PittRocketryTeam/Vehicle-Subsystem/hardware/PCBs/PowerDeliveryBoard.png

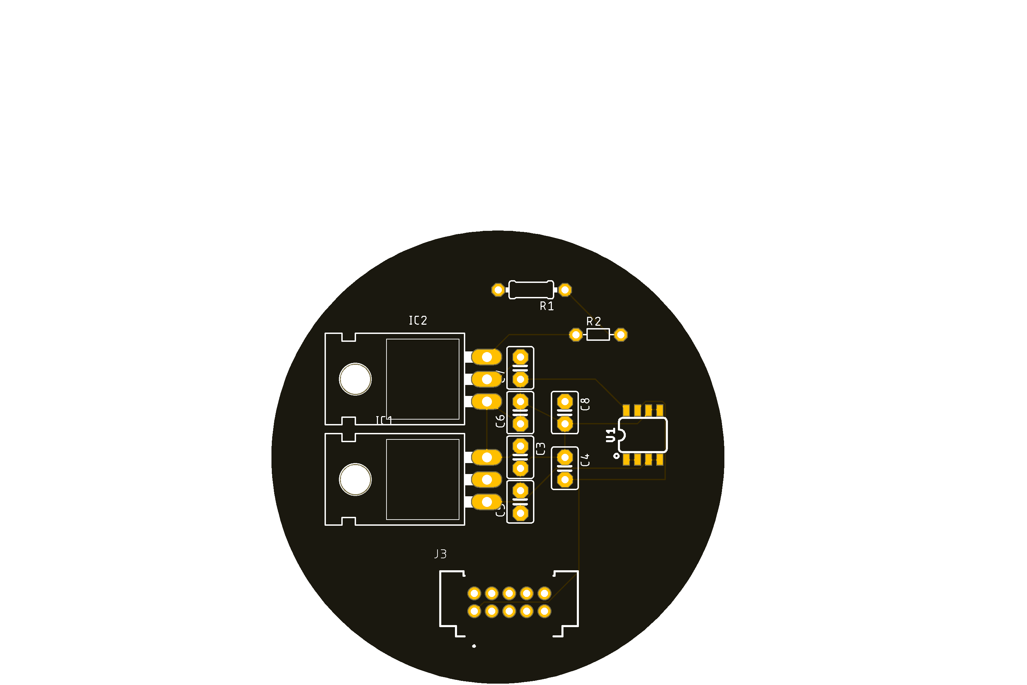
hardware/PCBs/PowerDeliveryBoard.png
