PittRocketryTeam/Vehicle-Subsystem/hardware/schematics/GroundStation/Ground_Station_Board.png

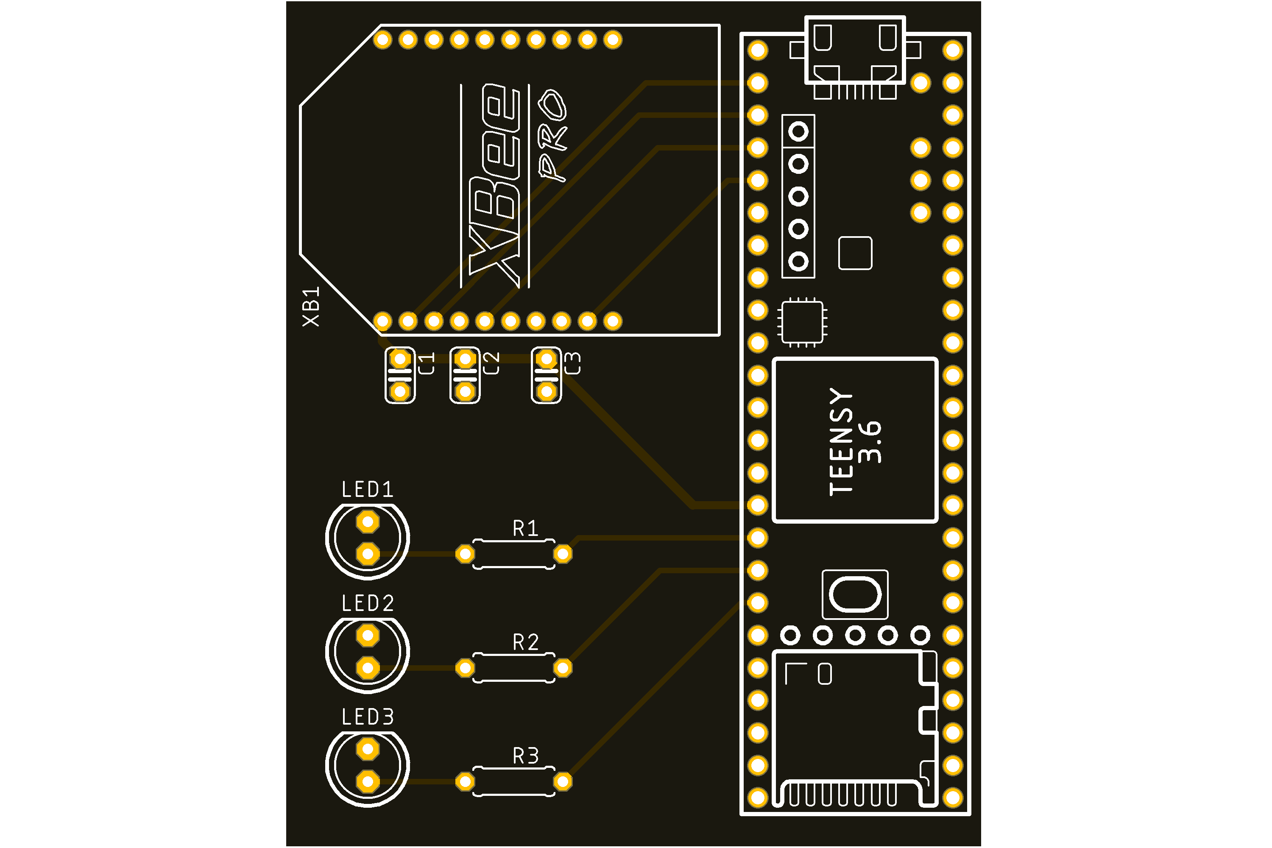
hardware/schematics/GroundStation/Ground_Station_Board.png
