PittRocketryTeam/Vehicle-Subsystem/hardware/schematics/MainBoard/MainBoard.png

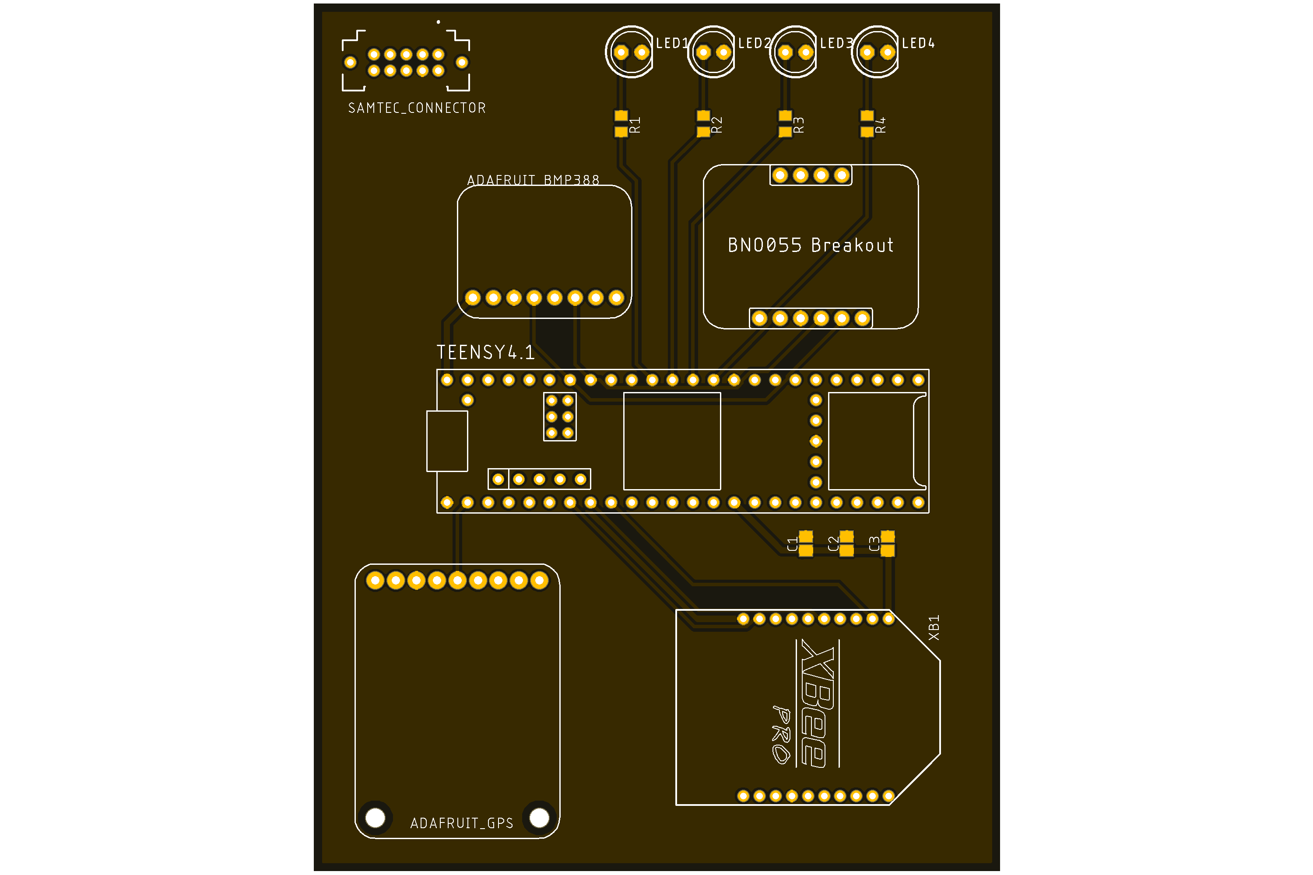
hardware/schematics/MainBoard/MainBoard.png
