PittRocketryTeam/Vehicle-Subsystem/hardware/schematics/GroundStation/Ground_Station_PCB.pdf

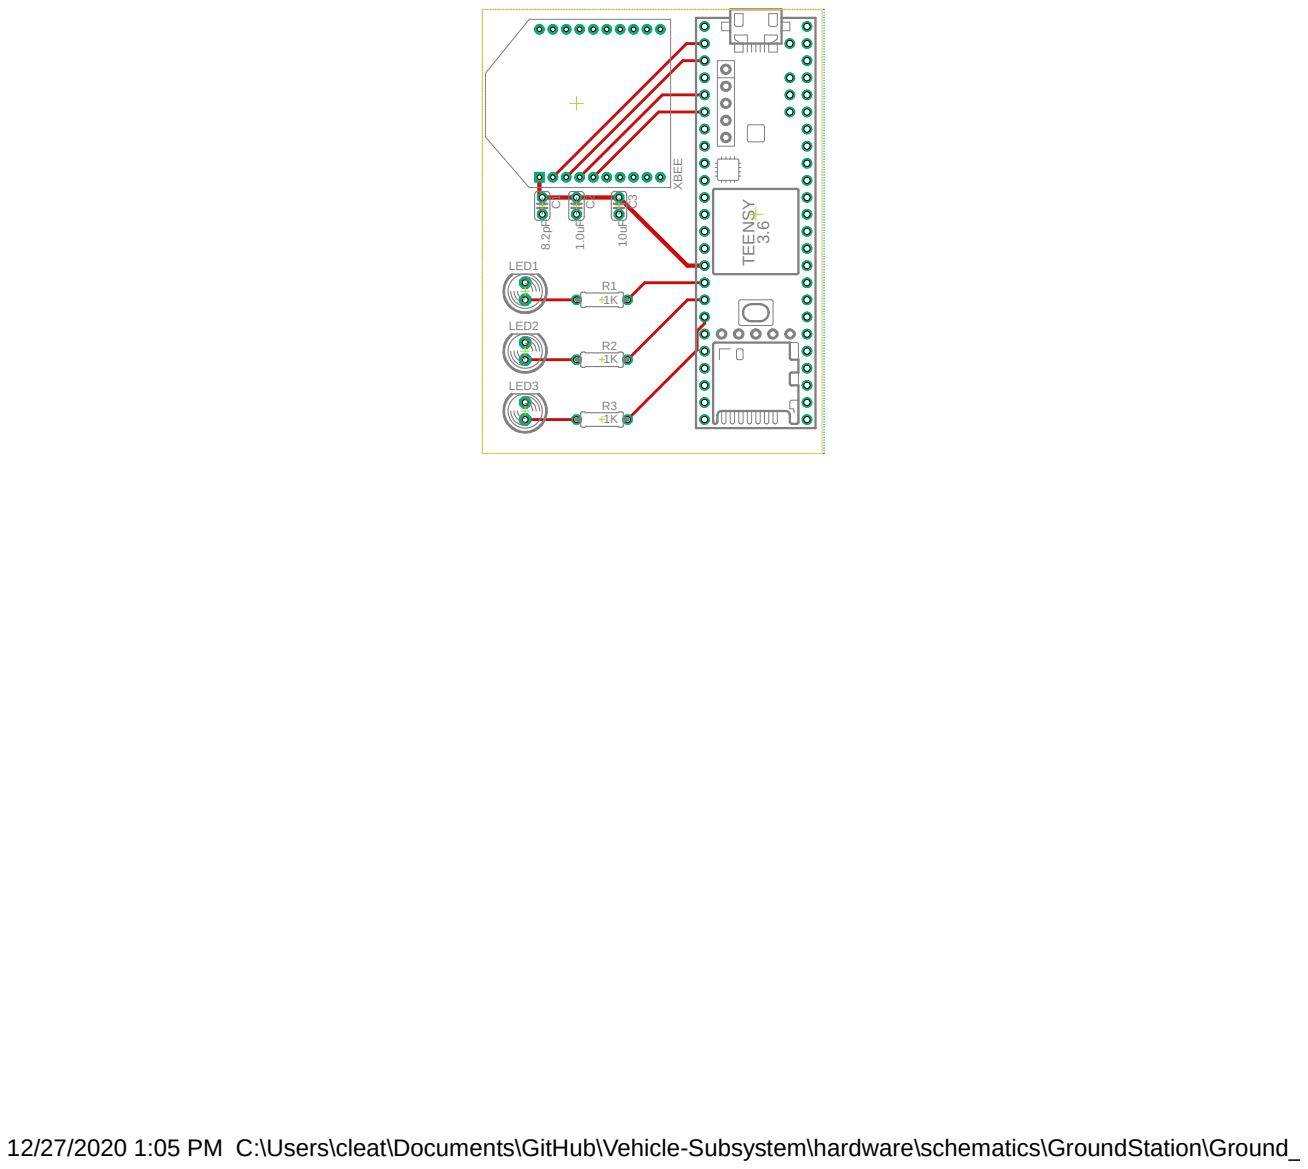
[picture p4: page 1]
12/27/2020 1:05 PM C:\Users\cleat\Documents\GitHub\Vehicle-Subsystem\hardware\schematics\GroundStation\Ground_Station_Board.brd TEENSY 3.6 C¹; LED1; LED2; LED3; XBEE 8.2pF
