PittRocketryTeam/Vehicle-Subsystem/hardware/schematics/MainBoard/MainboardPCB.pdf

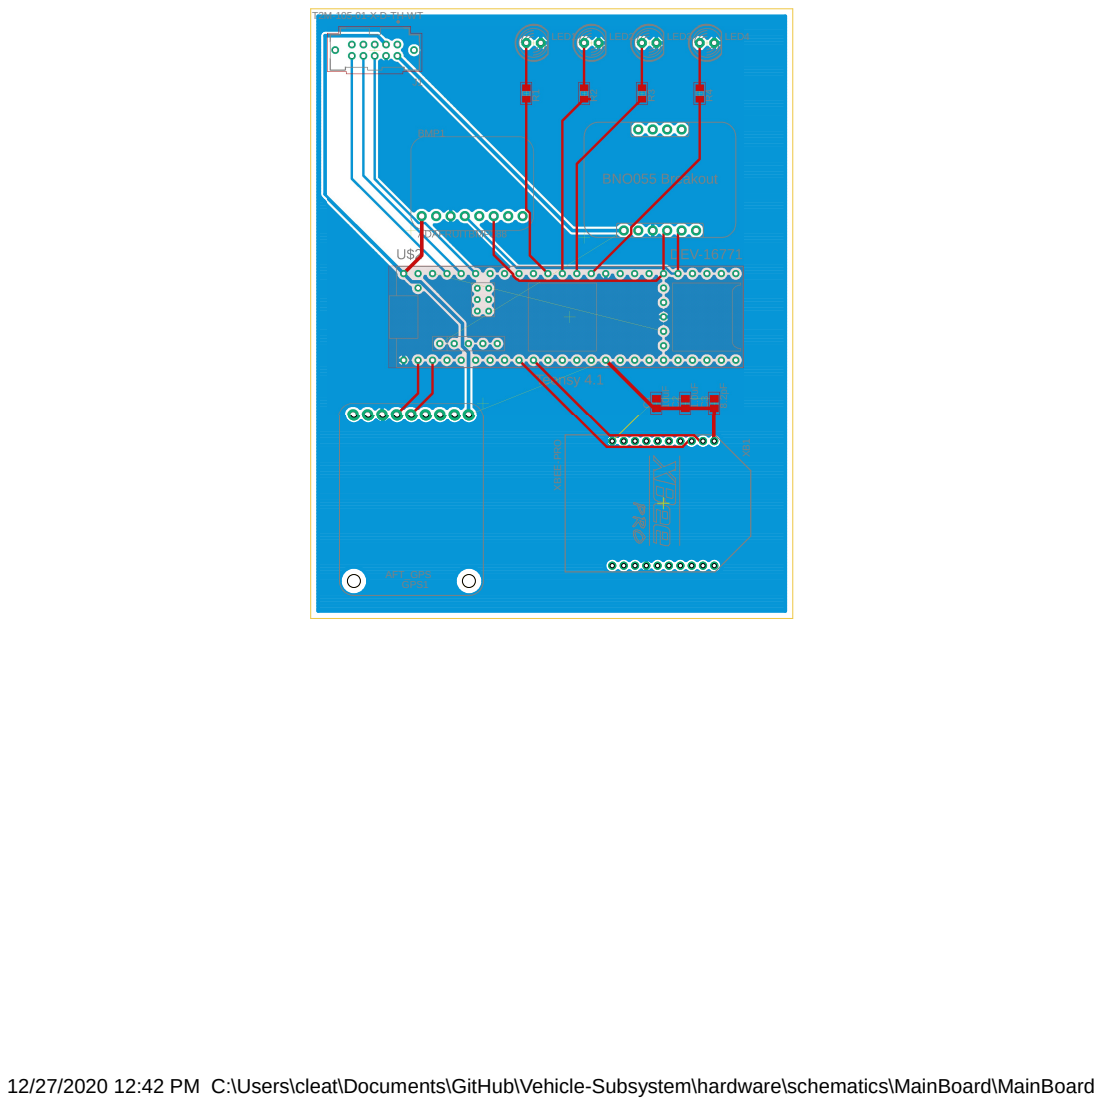
[picture p5: page 1]
GPS1; AFT_GPS; XBEE⁻PRO

12/27/2020 12:42 PM C:\Users\cleat\Documents\GitHub\Vehicle-Subsystem\hardware\schematics\MainBoard\MainBoard.brd
