PittRocketryTeam/Vehicle-Subsystem/hardware/schematics/MainBoard/MainboardSchematic.pdf

## Indicator LED's

## Power Board Connector

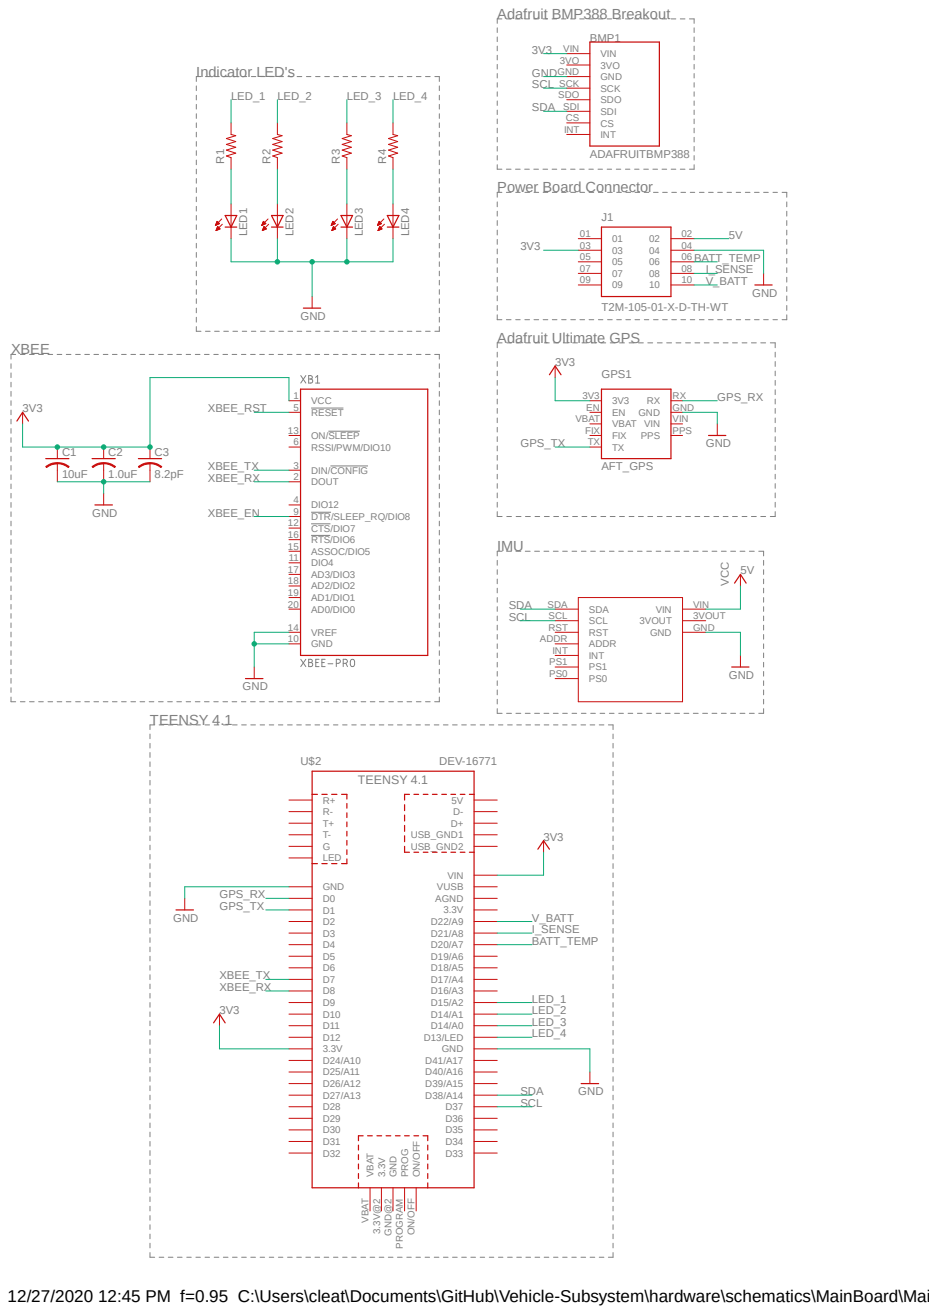
[picture p6: page 1]

12/27/2020 12:45 PM f=0.95 C:\Users\cleat\Documents\GitHub\Vehicle-Subsystem\hardware\schematics\MainBoard\MainBoard.sch (Sheet: 1/1)
