PittRocketryTeam/Vehicle-Subsystem/hardware/schematics/GroundStation/Ground_Station_Schematic.pdf

## Indicator LEDS

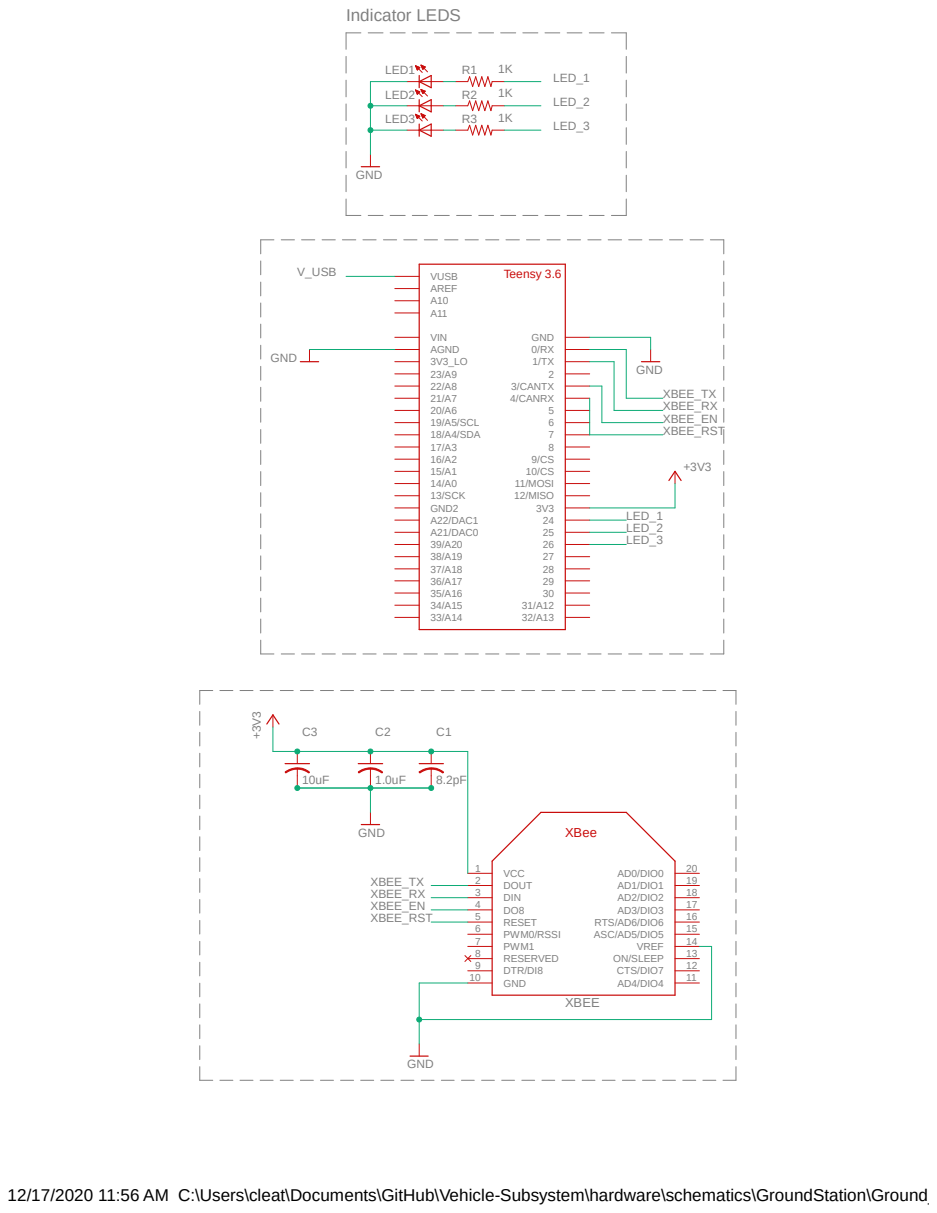
[picture p7: page 1]

12/17/2020 11:56 AM C:\Users\cleat\Documents\GitHub\Vehicle-Subsystem\hardware\schematics\GroundStation\Ground_Station_Board.sch (Sheet: 1/1)
