PittRocketryTeam/Vehicle-Subsystem/hardware/Finished Designs/Power Delivery Board/PowerDeliveryBoard.brd

## EAGLE design hardware/Finished Designs/Power Delivery Board/PowerDeliveryBoard.brd (2021-01-24)

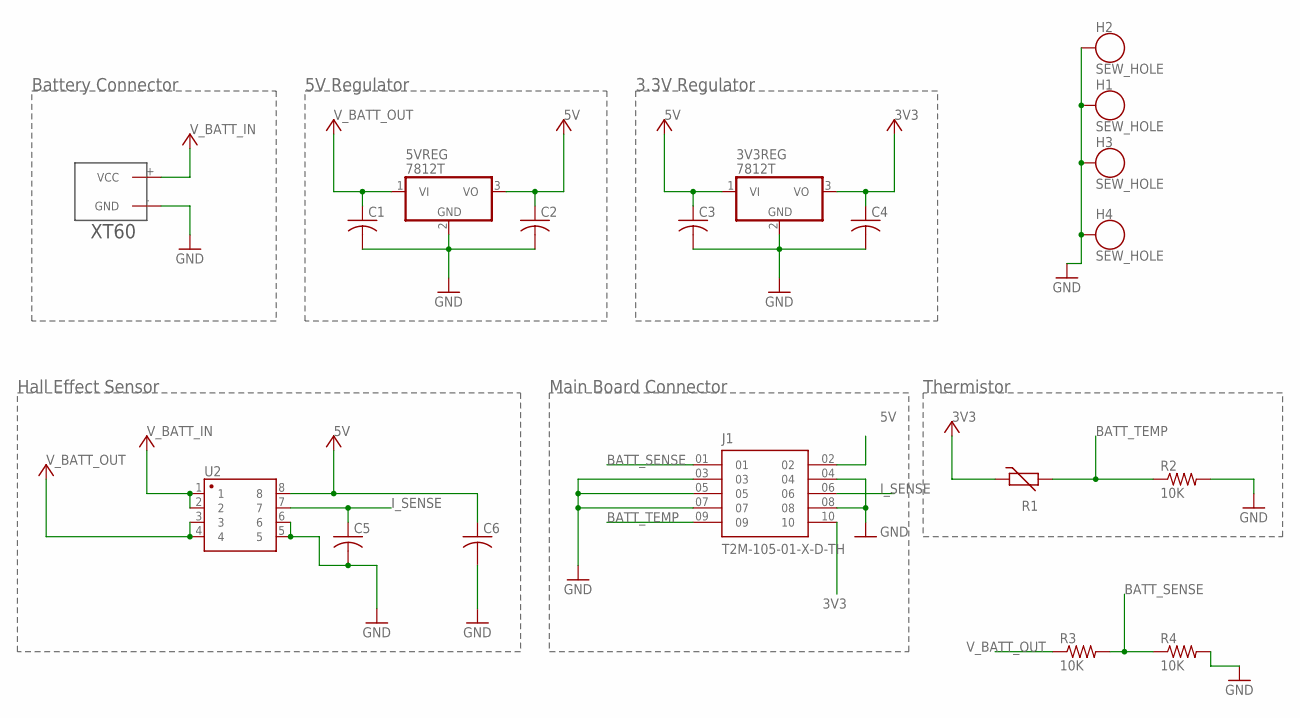
[picture p8: schematic PowerDeliveryBoard.sch]

Parts:
3V3REG, 5VREG: 7812T; TO220H
C1, C2, C3, C4, C5, C6: C-USC0805; C0805
H1, H2, H3, H4: SEW_HOLE; SIMPLE_HOLE
J1: T2M-105-01-X-D-TH; SAMTEC_T2M-105-01-X-D-TH
R1: THERMISTOR-5; R-5
R2, R3, R4: 10K; R0805
U2: ASC723; SO08
U$3: XT60_XT60

Connections:
3V3: 3V3REG.3 (VO), C4.1, J1.10, R1.1
5V: 3V3REG.1 (VI), 5VREG.3 (VO), C2.1, C3.1, C6.1, J1.02, U2.8
BATT_SENSE: J1.01, R3.2, R4.1
BATT_TEMP: J1.09, R1.2, R2.1
GND: 3V3REG.2 (GND), 5VREG.2 (GND), C1.2, C2.2, C3.2, C4.2, C5.2, C6.2, H1.P$1, H2.P$1, H3.P$1, H4.P$1, J1.03, J1.04, J1.05, J1.07, J1.08, R2.2, R4.2, U2.5, U2.6, U$3.- (GND)
I_SENSE: C5.1, J1.06, U2.7
V_BATT_IN: U2.1, U2.2, U$3.+ (VCC)
V_BATT_OUT: 5VREG.1 (VI), C1.1, R3.1, U2.3, U2.4

Notes on the sheet:
Hall Effect Sensor
5V Regulator
3.3V Regulator
Thermistor
Battery Connector
Main Board Connector

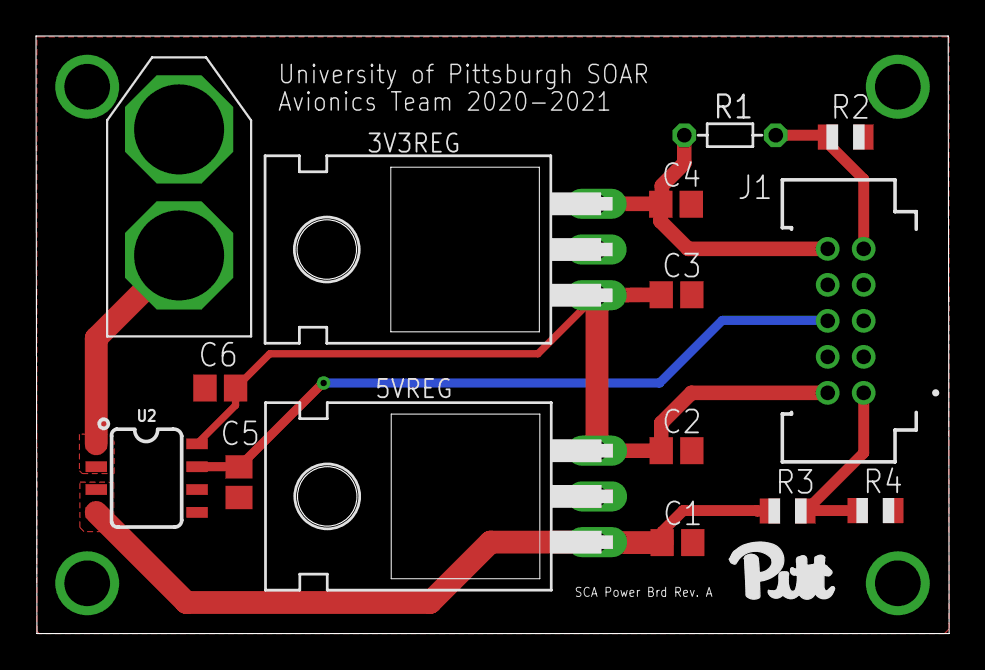
[picture p9: board hardware/Finished Designs/Power Delivery Board/PowerDeliveryBoard.brd from above]

Board: 2 copper layers, 50.7 x 33.2 mm, 19 parts (0 on the bottom side), 8 nets.
