PittRocketryTeam/Vehicle-Subsystem/hardware/Finished Designs/Ground Station/Ground_Station_Board.brd

## EAGLE design hardware/Finished Designs/Ground Station/Ground_Station_Board.brd (2021-01-24)

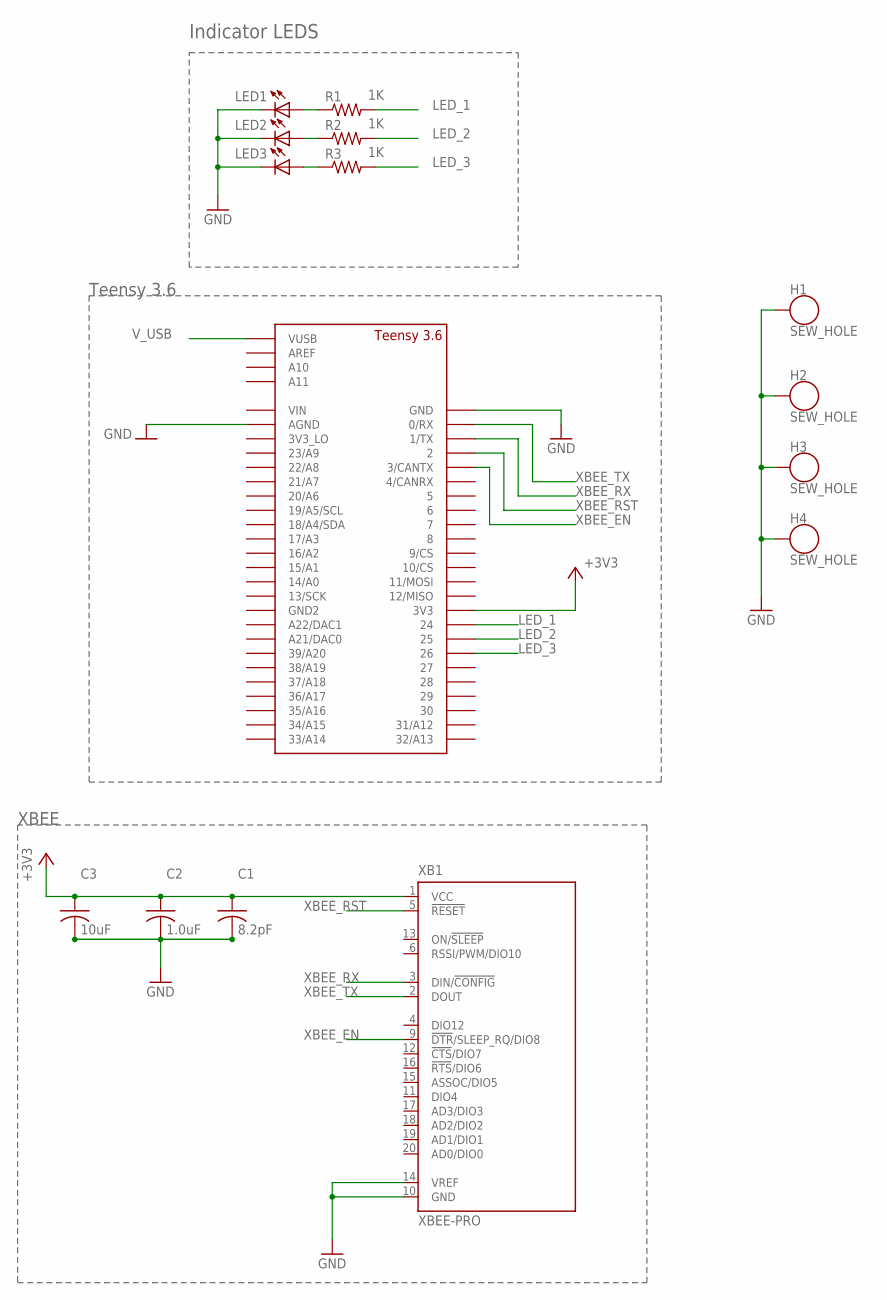
[picture p10: schematic Ground_Station_Board.sch]

Parts:
C1: 8.2pF; C025-024X044
C2: 1.0uF; C025-024X044
C3: 10uF; C025-024X044
H1, H2, H3, H4: SEW_HOLE; SIMPLE_HOLE
LED1, LED2, LED3: LED5MM
R1, R2, R3: 1K; 0207/7
U$2: TEENSY_3.5/3.6_BASIC
XB1: XBEE-PRO

Connections:
+3V3: C1.1, C2.1, C3.1, U$2.3V3, XB1.1 (VCC)
GND: C1.2, C2.2, C3.2, H1.P$1, H2.P$1, H3.P$1, H4.P$1, LED1.K (C), LED2.K (C), LED3.K (C), U$2.AGND, U$2.GND, XB1.10 (GND), XB1.14 (VREF)
LED_1: R1.2, U$2.24
LED_2: R2.2, U$2.25
LED_3: R3.2, U$2.26
unnamed: LED1.A, R1.1
unnamed: LED2.A, R2.1
unnamed: LED3.A, R3.1
V_USB: U$2.VUSB
XBEE_EN: U$2.3/CANTX, XB1.9 (!DTR!/SLEEP_RQ/DIO8)
XBEE_RST: U$2.2, XB1.5 (!RESET)
XBEE_RX: U$2.1/TX, XB1.3 (DIN/!CONFIG)
XBEE_TX: U$2.0/RX, XB1.2 (DOUT)

Notes on the sheet:
Indicator LEDS
XBEE
Teensy 3.6

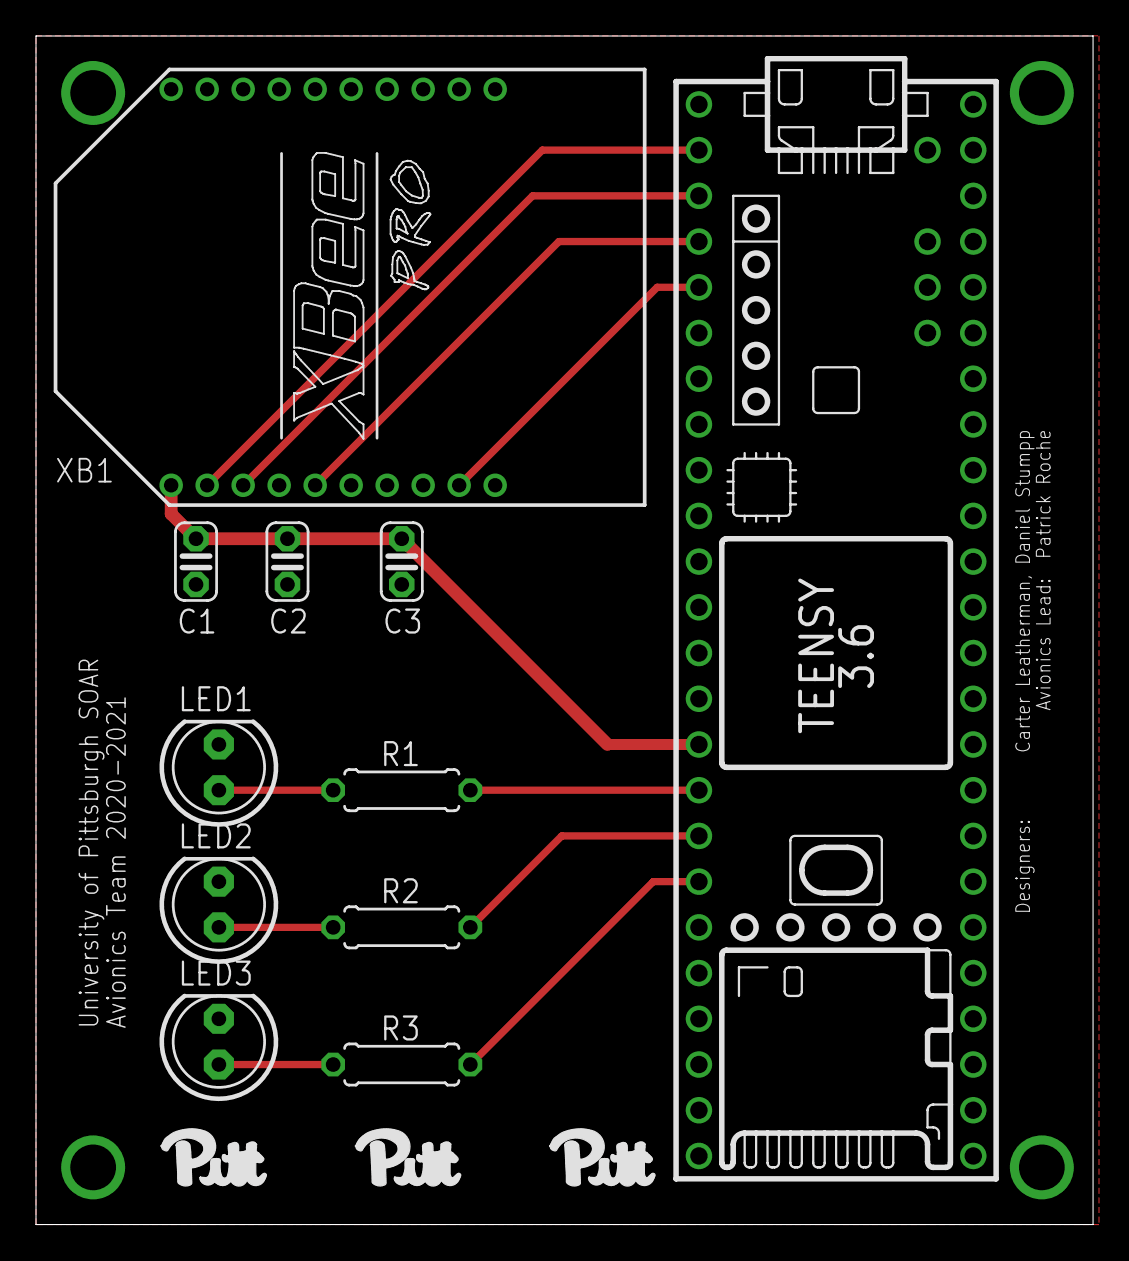
[picture p11: board Ground_Station_Board.brd from above]

Board: 2 copper layers, 58.7 x 66.0 mm, 15 parts (0 on the bottom side), 12 nets.
