PittRocketryTeam/Vehicle-Subsystem/hardware/Finished Designs/Main Board/MainBoard.brd

## EAGLE design hardware/Finished Designs/Main Board/MainBoard.brd (2021-01-24)

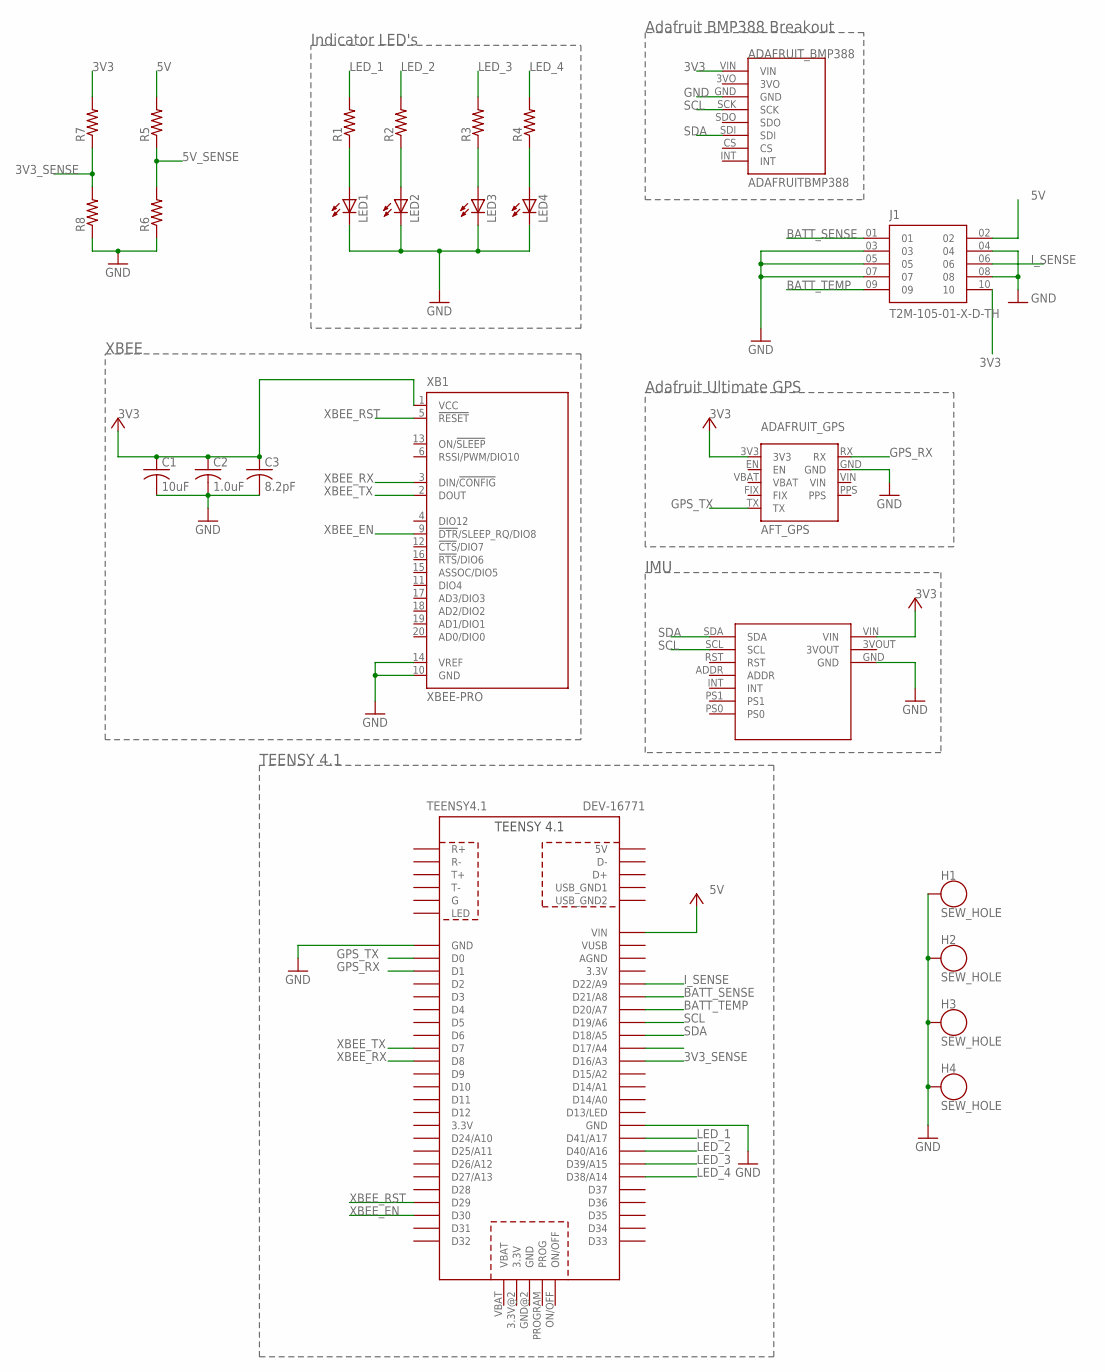
[picture p12: schematic MainBoard.sch]

Parts:
ADAFRUIT_BMP388: ADAFRUITBMP388
ADAFRUIT_GPS: AFT_GPS
C1: 10uF; C0805
C2: 1.0uF; C0805
C3: 8.2pF; C0805
H1, H2, H3, H4: SEW_HOLE; SIMPLE_HOLE
J1: T2M-105-01-X-D-TH; SAMTEC_T2M-105-01-X-D-TH
LED1, LED2, LED3, LED4: LED5MM
R1, R2, R3, R4, R5, R6, R7, R8: R-US_R0805; R0805
TEENSY4.1: DEV-16771
U$1: IMU_BREAKOUT; BNO055_BREAKOUT
XB1: XBEE-PRO

Connections:
3.3V: TEENSY4.1.3.3V, TEENSY4.1.3.3V@1 (3.3V), TEENSY4.1.3.3V@2 (3.3V)
3V3: ADAFRUIT_BMP388.VIN, ADAFRUIT_GPS.3V3, C1.1, C2.1, C3.1, J1.10, R7.2, U$1.VIN, XB1.1 (VCC)
3V3_SENSE: R7.1, R8.2, TEENSY4.1.D17/A3 (D16/A3)
5V: J1.02, R5.2, TEENSY4.1.5V, TEENSY4.1.VIN
5V_SENSE: R5.1, R6.2, TEENSY4.1.D18/A4 (D17/A4)
AGND: TEENSY4.1.AGND
BATT_SENSE: J1.01, TEENSY4.1.D22/A8 (D21/A8)
BATT_TEMP: J1.09, TEENSY4.1.D21/A7 (D20/A7)
G: TEENSY4.1.G
GND: ADAFRUIT_BMP388.GND, ADAFRUIT_GPS.GND, C1.2, C2.2, C3.2, H1.P$1, H2.P$1, H3.P$1, H4.P$1, J1.03, J1.04, J1.05, J1.07, J1.08, LED1.K (C), LED2.K (C), LED3.K (C), LED4.K (C), R6.1, R8.1, TEENSY4.1.GND, TEENSY4.1.GND@1 (GND), TEENSY4.1.GND@2 (GND), U$1.GND, XB1.10 (GND), XB1.14 (VREF)
GPS_RX: ADAFRUIT_GPS.RX, TEENSY4.1.D1
GPS_TX: ADAFRUIT_GPS.TX, TEENSY4.1.D0
I_SENSE: J1.06, TEENSY4.1.D23/A9 (D22/A9)
LED_1: R1.2, TEENSY4.1.D41/A17
LED_2: R2.2, TEENSY4.1.D40/A16
LED_3: R3.2, TEENSY4.1.D39/A15
LED_4: R4.2, TEENSY4.1.D38/A14
unnamed: LED1.A, R1.1
unnamed: LED2.A, R2.1
unnamed: LED3.A, R3.1
unnamed: LED4.A, R4.1
SCL: ADAFRUIT_BMP388.SCK, TEENSY4.1.D20/A6 (D19/A6), U$1.SCL
SDA: ADAFRUIT_BMP388.SDI, TEENSY4.1.D19/A5 (D18/A5), U$1.SDA
USB_GND1: TEENSY4.1.USB_GND (USB_GND1)
USB_GND2: TEENSY4.1.USB_GND@2 (USB_GND2)
VBAT: TEENSY4.1.VBAT
VUSB: TEENSY4.1.VUSB
XBEE_EN: TEENSY4.1.D30, XB1.9 (!DTR!/SLEEP_RQ/DIO8)
XBEE_RST: TEENSY4.1.D29, XB1.5 (!RESET)
XBEE_RX: TEENSY4.1.D8, XB1.3 (DIN/!CONFIG)
XBEE_TX: TEENSY4.1.D7, XB1.2 (DOUT)

Notes on the sheet:
Indicator LED's
Adafruit Ultimate GPS
XBEE
TEENSY 4.1
IMU
Adafruit BMP388 Breakout

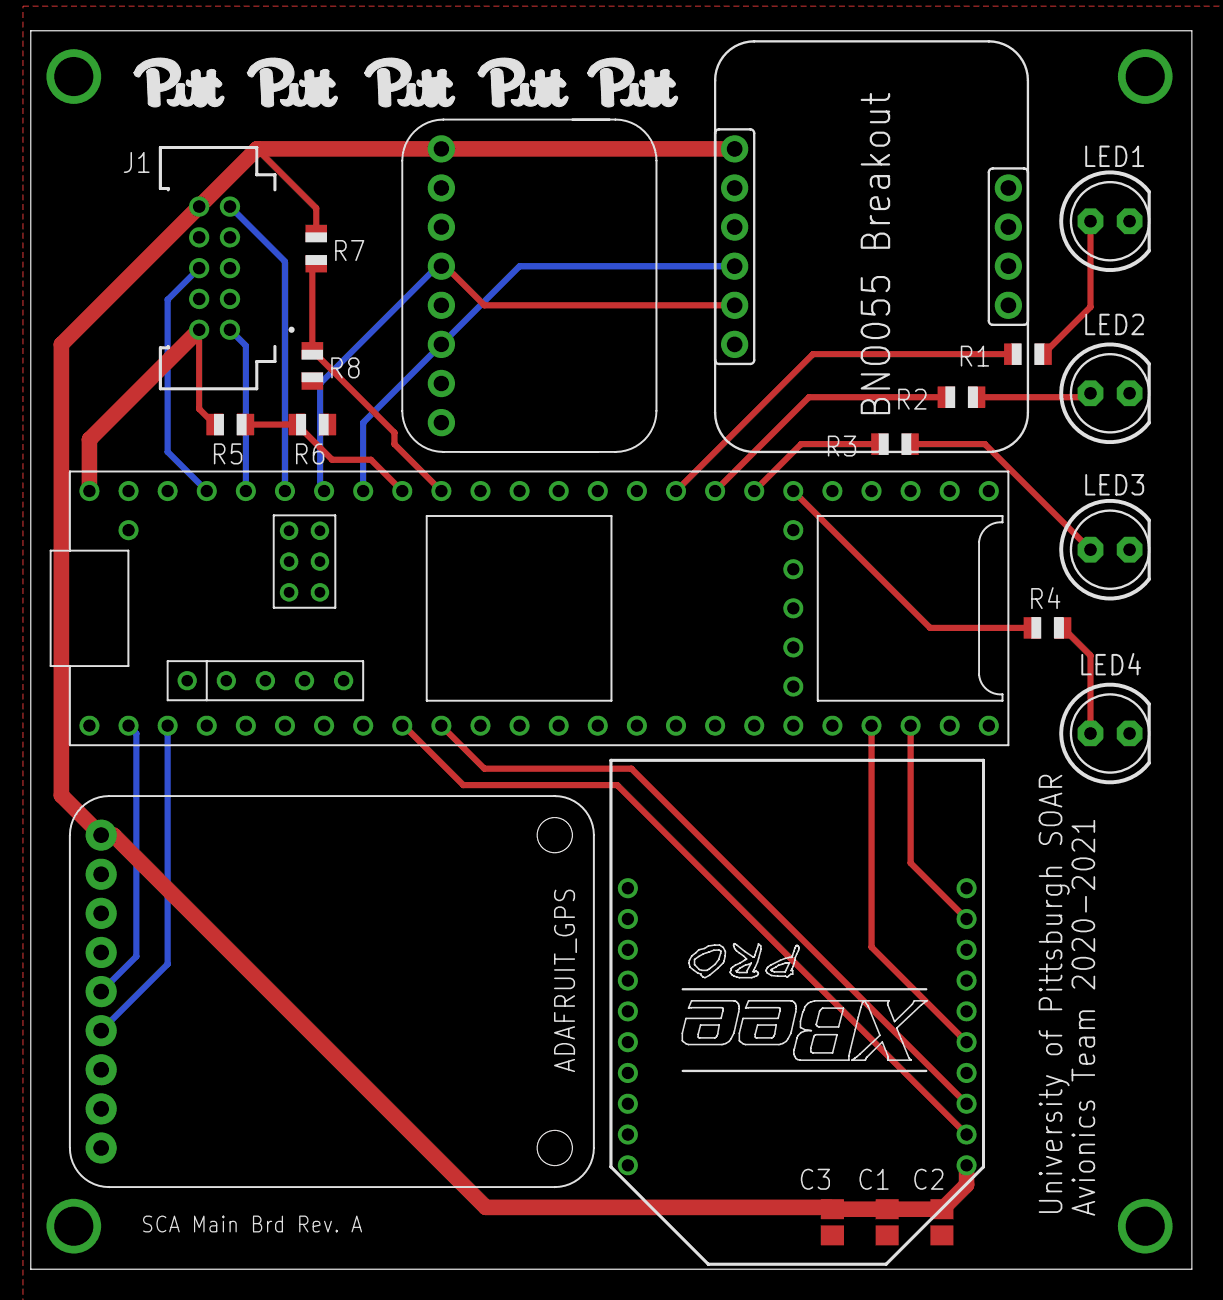
[picture p13: board MainBoard.brd from above]

Board: 2 copper layers, 75.4 x 80.4 mm, 25 parts (0 on the bottom side), 25 nets.
