PittRocketryTeam/Vehicle-Subsystem/hardware/schematics/PowerBoard/PowerDeliveryBoard.brd

## EAGLE design hardware/schematics/PowerBoard/PowerDeliveryBoard.brd (2021-01-23, an earlier design)

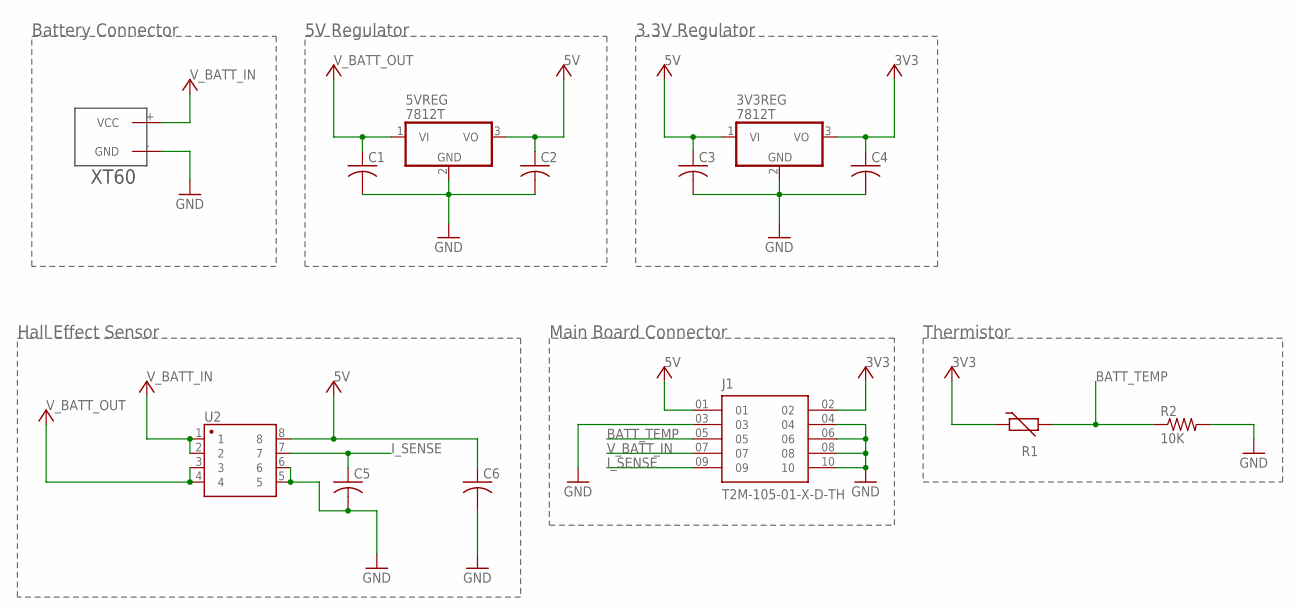
[picture p14: schematic PowerDeliveryBoard.sch]

Parts:
3V3REG, 5VREG: 7812T; TO220H
C1, C2, C3, C4, C5, C6: C-USC0805; C0805
J1: T2M-105-01-X-D-TH; SAMTEC_T2M-105-01-X-D-TH
R1: THERMISTOR-5; R-5
R2: 10K; R0805
U2: ASC723; SO08
U$3: XT60_XT60

Connections:
3V3: 3V3REG.3 (VO), C4.1, J1.02, R1.1
5V: 3V3REG.1 (VI), 5VREG.3 (VO), C2.1, C3.1, C6.1, J1.01, U2.8
BATT_TEMP: J1.05, R1.2, R2.1
GND: 3V3REG.2 (GND), 5VREG.2 (GND), C1.2, C2.2, C3.2, C4.2, C5.2, C6.2, J1.03, J1.04, J1.06, J1.08, J1.10, R2.2, U2.5, U2.6, U$3.- (GND)
I_SENSE: C5.1, J1.09, U2.7
V_BATT_IN: J1.07, U2.1, U2.2, U$3.+ (VCC)
V_BATT_OUT: 5VREG.1 (VI), C1.1, U2.3, U2.4

Notes on the sheet:
Hall Effect Sensor
5V Regulator
3.3V Regulator
Thermistor
Battery Connector
Main Board Connector

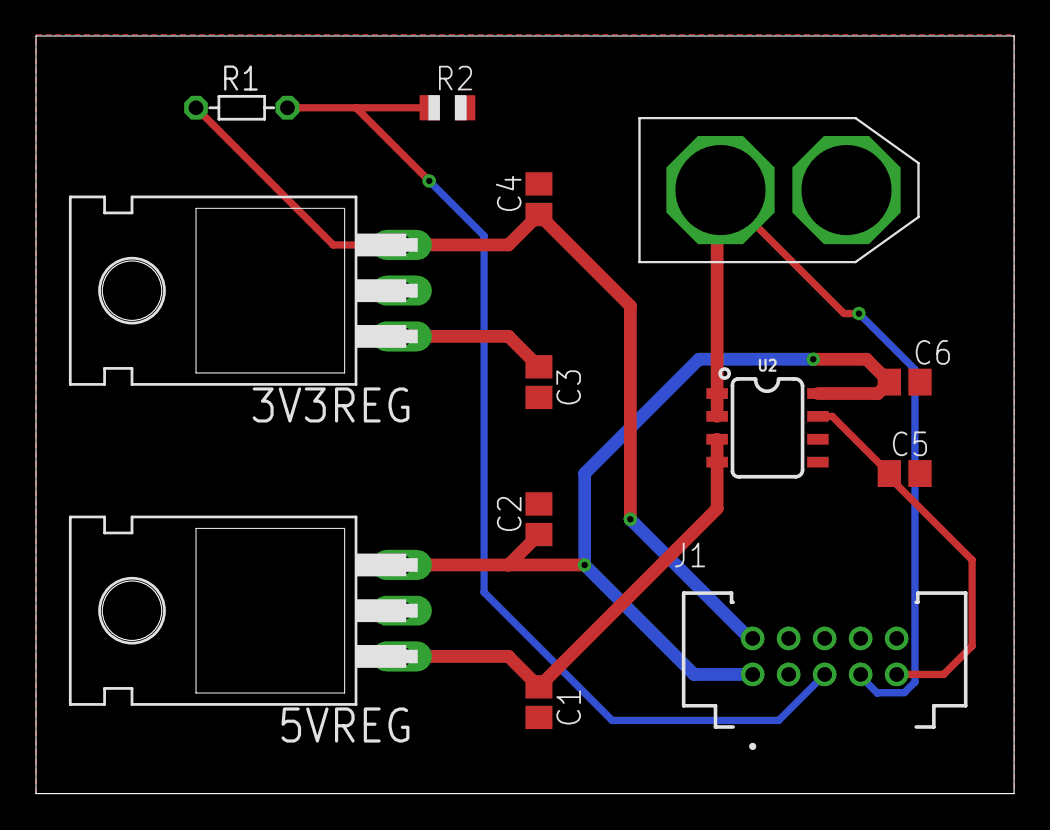
[picture p15: board hardware/schematics/PowerBoard/PowerDeliveryBoard.brd from above]

Board: 2 copper layers, 54.3 x 42.1 mm, 13 parts (0 on the bottom side), 7 nets.
