PittRocketryTeam/Vehicle-Subsystem/hardware/PCBs/PowerDeliveryBoard.brd

## EAGLE design hardware/PCBs/PowerDeliveryBoard.brd (2020-12-14, an earlier design)

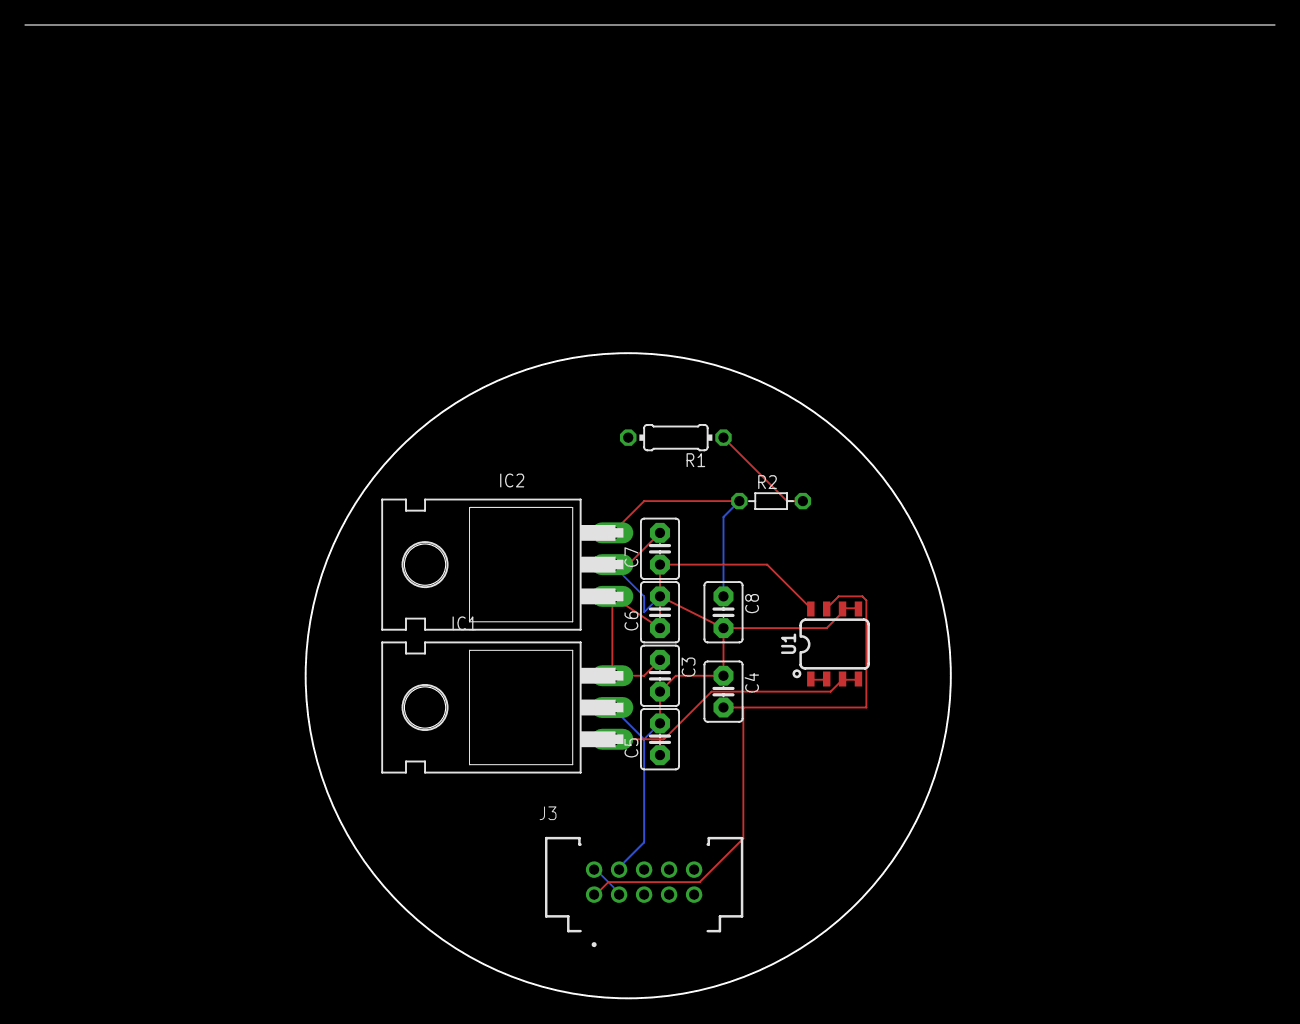
[picture p16: board hardware/PCBs/PowerDeliveryBoard.brd from above]

Board: 2 copper layers, 51.6 x 51.6 mm, 12 parts (0 on the bottom side), 8 nets.

Parts:
C3: .1 uF; C2.5-3
C4: C2.5-3
C5, C7: 1uF; C2.5-3
C6, C8: .1uF; C2.5-3
IC1, IC2: 7812T; TO220H
J3: T2M-105-01-X-D-TH; SAMTEC_T2M-105-01-X-D-TH
R1: 0; 0204/7
R2: THERMISTOR-5; R-5
U1: GENERIC-SOIC8MSGEQ7N-FILTER; SO08

Connections:
+3V3: C8.1, IC2.3, R2.1
+5V: C3.1, C6.1, C7.1, IC1.3, IC2.1, U1.8
GND: C3.2, C4.1, C5.2, C6.2, C7.2, C8.2, IC1.2, IC2.2, J3.04, U1.5, U1.6
unnamed: R1.1, R2.2
VCC: J3.02, J3.03
VI_OUT: C4.2, J3.01, U1.7
V_BATT: C5.1, IC1.1, U1.3, U1.4
V_BATT_IN: U1.1, U1.2
