PittRocketryTeam/Vehicle-Subsystem/software/include/Health.hpp

#ifndef __HEALTH_HPP__
#define __HEALTH_HPP__

#define MOHM 1e6
#define KOHM 1e3
#define THERMISTOR_T0 298.15
#define ANALOG_MAX 4096

#include "Sensor.hpp"
#include "protocol.hpp"

class Health : public Sensor
{
    public:

        Health();
        ~Health();
            
        virtual void init();
        virtual void read(state*);
        virtual void poll(state*);
        virtual void enable();
        virtual void disable();

    private:
        //float calculate_voltage(int, float, float);
        //float calculate_temperature(int, float);

        float battery_temperature;
        float battery_voltage;
        float battery_current;
        float reg5_voltage;
        float reg3_voltage;
        
        bool enabled;
};

#endif /* __HEALTH_HPP__ */
