PittRocketryTeam/Vehicle-Subsystem/software/include/Logger.hpp

#ifndef __LOGGER_HPP__
#define __LOGGER_HPP__

#include <assert.h>
#include "Sensor.hpp"
#include <SPI.h>
#include <SD.h>
#include <TimeLib.h>
#include "protocol.hpp"

//#define BUILTIN_SDCARD 254

class Logger
{
    public:

        Logger();
        ~Logger();

        /**
         * Initialize the logger. Returns false if the initialization fails for 
         * any reason.
        */
        bool init();

        /**
         * Reads from each sensor and writes the timestamped data to the disk. 
         * Returns true if data was successfully written, false if not (either because
         * the number of bytes that should have been written to the disk was not written
         * or because the micro SD couldn't be opened).
         */

        void reopen();
        void close();
        void flush();

        //virtual bool writeToMemory(Data);
        void write(state*);

    private:

        /**
         * Create a unique log file name based on the current time and date and
         * return it.
         * 
         * Example log filename: Monday_10-07-2019_03:26:41.log
        */
        //virtual void generateFilename();
        void genUniqueFn();

        static time_t getTeensy3Time();

        state snapshot[100];
        state* snp;
        char filename[128];
        char buffer[8192];
        char* bp;
        File handle;
};

#endif
// __LOGGER_HPP__
