PittRocketryTeam/Vehicle-Subsystem/(commit log)

2020-10-25 Delete Ground_Station_Board.sch
    Wrong folder
    [Ground_Station_Board.sch]
2020-11-01 changes from review
    [PowerDeliveryBoard.sch]
2020-12-11 Add files via upload
    Updated resistor and capacitor values
    [Ground_Station_Board.sch]
2020-12-17 RF_Board upload
    [RF_Board.sch]
2020-12-17 Everything in one folder
    [Ground_Station_Board.brd, Ground_Station_Board.sch]
2020-12-17 board's smaller now
    [Ground_Station_Board.brd, Ground_Station_Board.sch]
2020-12-17 Wider power trace
    [Ground_Station_Board.brd]
2020-12-22 .sch+.brd of Main Board | still needs altimeter
    [Ground_Station_Board.brd, MainBoard.brd, MainBoard.sch]
2020-12-27 Added BMP388 & PDF's
    [MainBoard.brd, MainBoard.sch]
2020-12-27 Added render image
    [MainBoard.sch]
2020-12-29 Updates
    Made power traces wider
    Added XBEE enable and reset traces
    Moved I2C pins to correct pins on teensy
    Made caps 805 size
    [MainBoard.brd, MainBoard.sch]
2020-12-29 Added top layer ground pour
    [MainBoard.brd]
2020-12-30 Fixed TX/RX pins for GPS and Xbee
    [MainBoard.brd, MainBoard.sch]
2020-12-31 Changed Xbee -> Xbee-Pro | Added render png
    [Ground_Station_Board.brd, Ground_Station_Board.sch]
2021-01-21 MainBoard Power routing & Power Board PNG
    [MainBoard.sch, RF_Board.sch]
2021-01-22 Add Power Board | Change MB Connector Pins | Move Old PDB.sch to PCBs Folder
    [MainBoard.brd, PowerDeliveryBoard.brd, PowerDeliveryBoard.sch]
2021-01-23 add hw timers
2021-01-24 Uploading Finalized Ground Station and Main Board
    [Ground_Station_Board.brd, Ground_Station_Board.sch, MainBoard.brd, MainBoard.sch]
2021-01-24 Uploading finalized power board
    [PowerDeliveryBoard.brd, PowerDeliveryBoard.sch]
2021-02-12 fix imu addr
2021-02-13 the gps FINALLY works, but I broke the IMU
    [GPS.cpp, MyXBee.cpp, main.cpp]
